zainaahui/Entrega1-Controlador-fisico/(list of files, cad)

Other CAD files:
cajita.3dm
