zainaahui/Entrega1-Controlador-fisico/IMG_3637.jpeg

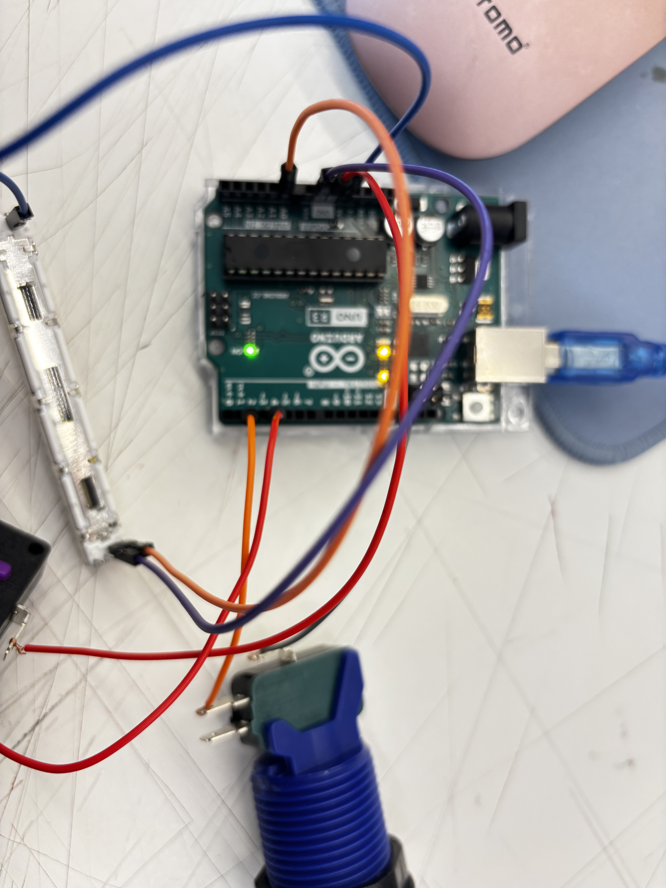
[picture p2: IMG_3637.jpeg]
IMG_3637.jpeg
