zainaahui/Entrega1-Controlador-fisico/intento1.2.jpeg

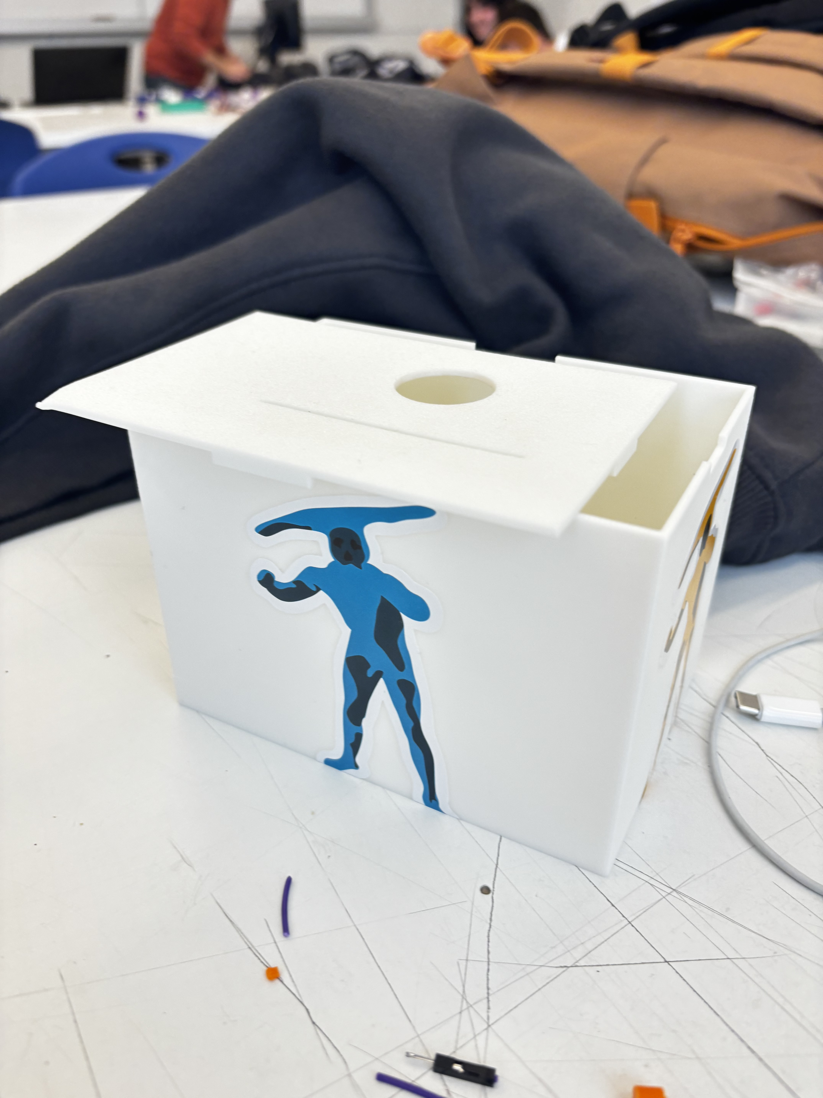
[picture p5: intento1.2.jpeg]
intento1.2.jpeg
